phisp/diyBMSv4/README

Slave Boards: 4.4mA
Master Board: 90 mA with pcf8574

2.5V Referenzspannung statt 2.048V!

Soldering:
Use flux!
Burn In Tests

Improvements:
1024 Slave Boards
Lower Current Consumption: Slave -> <1mA Master -> Stb: <1mA

Issues:

more than 500mV difference causes packet loss
Slave Stops Operating
