phisp/diyBMSv4/CellModules_LCSC_BillOfMaterials.xlsx

ID | LCSC Part Number | Manufacture Part Number | Manufacturer | Package | Description | RoHS | Order Qty. | Min\Mult Order Qty. | Unit Price | Order Price | Product Link
D3 | C84256 | FC-2012HRK-620D | Foshan NationStar Optoelectronics | 0805 | Light Emitting Diodes (LED) Red 615~630nm 67~195mcd@20mA Top View 0805 RoHS | yes | 500 | 50\50 | 0.01290 | 6.45 | https://lcsc.com/product-detail/Light-Emitting-Diodes-LED_Red-LED-SMDLED-80-180mcd_C84256.html
D4 | C84260 | FC-2012UGK-520D5 | Foshan NationStar Optoelectronics | 0805 | Light Emitting Diodes (LED) Green 525~537.5nm 180~400mcd@5mA Top View 0805 RoHS | yes | 200 | 20\20 | 0.01520 | 3.04 | https://lcsc.com/product-detail/Light-Emitting-Diodes-LED_Emerald-SMDLED-Iv-220-270mcd-atIF-5mA_C84260.html
Q1 | C143946 | IRLML6244TRPBF | Infineon Technologies | SOT-23(SOT-23-3) | MOSFET N Trench 20V 6.3A 1.1V @ 10uA 21 mΩ @ 6.3A，4.5V SOT-23(SOT-23-3) RoHS | yes | 200 | 5\5 | 0.06570 | 13.14 | https://lcsc.com/product-detail/MOSFET_Infineon-Technologies_IRLML6244TRPBF_Infineon-Technologies-IRLML6244TRPBF_C143946.html
~~R1 Doppelt?~~ | ~~C17414~~ | ~~0805W8F1002T5E~~ | ~~Uniroyal Elec~~ | ~~0805~~ | ~~Chip Resistor - Surface Mount 10KOhms ±1% 1/8W 0805 RoHS~~ | ~~yes~~ | ~~1000~~ | ~~100\100~~ | ~~0.00100~~ | ~~1.00~~ | ~~https://lcsc.com/product-detail/Chip-Resistor-Surface-Mount_Uniroyal-Elec-0805W8F1002T5E_C17414.html~~
R1 | C84376 | RC0805FR-0710KL | YAGEO | 0805 | Chip Resistor - Surface Mount 10KOhms ±1% 1/8W 0805 RoHS | yes | 100 | 100\100 | 0.00170 | 0.17 | https://lcsc.com/product-detail/Chip-Resistor-Surface-Mount_10KR-1002-1_C84376.html
~~R2 Doppelt?~~ | ~~C95781~~ | ~~RC0805FR-071KL~~ | ~~YAGEO~~ | ~~0805~~ | ~~Chip Resistor - Surface Mount 1KOhms ±1% 1/8W 0805 RoHS~~ | ~~yes~~ | ~~1000~~ | ~~100\100~~ | ~~0.00110~~ | ~~1.10~~ | ~~https://lcsc.com/product-detail/Chip-Resistor-Surface-Mount_1KR-1000-1_C95781.html~~
R2 | C115316 | RS-05K1001FT | Guangdong Fenghua Advanced Tech | 0805 | Chip Resistor - Surface Mount 1KOhms ±1% 1/8W 0805 RoHS | yes | 1000 | 100\100 | 0.00100 | 1.00 | https://lcsc.com/product-detail/Chip-Resistor-Surface-Mount_1KR-1001-1_C115316.html
R15, R20, R21 | C126351 | RC0805FR-0747KL | YAGEO | 0805 | Chip Resistor - Surface Mount 47KOhms ±1% 1/8W 0805 RoHS | yes | 1000 | 50\50 | 0.00470 | 3.20 | https://lcsc.com/product-detail/Chip-Resistor-Surface-Mount_47KR-4702-1_C126351.html
 | C95969 | SDNT2012X473F4150FTF | Sunlord | 0805 | NTC Thermistors 1/5W 47KOhms ±1% 4150K 0805 RoHS | yes | 20 | 10\10 | 0.03940 |  | https://lcsc.com/product-detail/NTC-Thermistors_47K-1-B-4150_C95969.html
 |  |  | Epcos | 0805 | NTC von Epcos 10k +-2% SMD-Geh. 0805 bleifrei |  | 10 | 10\10 | 0.25000 | 2.50 | https://www.ebay.de/itm/10-St-NTC-von-Epcos-10k-2-SMD-Geh-0805-bleifrei
U1, ESP_U2 Punkt Links | C232857 | HMHA2801 | ON Semicon | SOP-4_P1.27 | DIP Optocouplers SOP-4_P1.27 RoHS | yes | 150 | 1\1 | 0.17733 | 26.60 | https://lcsc.com/product-detail/DIP-Optocouplers_ON-Semicon_HMHA2801_ON-Semicon-ON-HMHA2801_C232857.html
C1 | C49678 | CC0805KRX7R9BB104 | YAGEO | 0805 | Multilayer Ceramic Capacitors MLCC - SMD/SMT 100nF 50V 0805 RoHS | yes | 500 | 50\50 | 0.00490 | 2.45 | https://lcsc.com/product-detail/Multilayer-Ceramic-Capacitors-MLCC-SMD-SMT_100nF-104-10-50V_C49678.html
C2 | C113841 | CC0805KKX5R7BB225 | YAGEO | 0805 | Multilayer Ceramic Capacitors MLCC - SMD/SMT 2.2uF 16V 0805 RoHS | yes | 200 | 20\20 | 0.02090 | 3.45 | https://lcsc.com/product-detail/Multilayer-Ceramic-Capacitors-MLCC-SMD-SMT_2-2uF-225-10-16V_C113841.html
C3 | C272880 | CC0805KRX5R6BB106 | YAGEO | 0805 | Multilayer Ceramic Capacitors MLCC - SMD/SMT 10uF 10V 0805 RoHS | yes | 200 | 20\20 | 0.01760 | 3.52 | https://lcsc.com/product-detail/Others_YAGEO-CC0805KRX5R6BB106_C272880.html
D2 | C189307 | BL-HB335B-TRB-6 | Bright LED Elec | 0805 | Light Emitting Diodes (LED) Blue 465~470nm 25mcd@5mA 0805 RoHS | yes | 200 | 20\20 | 0.01460 | 2.92 | https://lcsc.com/product-detail/Light-Emitting-Diodes-LED_SMDLED-blue_C189307.html
- | C65114 | - | Boom Precision Elec | P=2.54mm | Pin Header / Female Header 0.100"（2.54mm） P=2.54mm RoHS | yes | 200 | 20\20 | 0.01440 | 2.88 | https://lcsc.com/product-detail/Pin-Header-Female-Header_Boom-Precision-Elec-2-54mm-2-3P-Header_C65114.html
~~doppelt~~ | ~~C124379~~ | ~~-~~ | ~~Shenzhen Cankemeng~~ | ~~Plugin~~ | ~~Pin Header / Female Header 0.100"（2.54mm） Plugin RoHS~~ | ~~yes~~ | ~~200~~ | ~~20\20~~ | ~~0.02040~~ | ~~4.08~~ | ~~https://lcsc.com/product-detail/Pin-Header-Female-Header_Shenzhen-Cankemeng-Headers-Pins-1-5P-2-54mm-Straight-line_C124379.html~~
- | C173752 | S2B-PH-K-S(LF)(SN) | JST Sales America | P=2mm | Wire To Board / Wire To Wire Connector P=2mm RoHS | yes | 400 | 10\10 | 0.02560 | 10.24 | https://lcsc.com/product-detail/Wire-To-Board-Wire-To-Wire-Connector_JST-Sales-America_S2B-PH-K-S-LF-SN_JST-Sales-America-S2B-PH-K-S-LF-SN_C173752.html
R3 | C137521 | RC0805FR-07475KL | YAGEO | 0805 | Chip Resistor - Surface Mount 475KOhms ±1% 1/8W 0805 RoHS | yes | 1000 | 100\100 | 0.00120 | 1.20 | https://lcsc.com/product-detail/_RC0805FR-07475KL_C137521.html
R4 | C17680 | 0805W8F4023T5E | Uniroyal Elec | 0805 | Chip Resistor - Surface Mount 402KOhms ±1% 1/8W 0805 RoHS | yes | 1000 | 100\100 | 0.00110 | 1.10 | https://lcsc.com/product-detail/Chip-Resistor-Surface-Mount_Uniroyal-Elec-0805W8F4023T5E_C17680.html
R5, R14 | C114563 | RC0805FR-07510RL | YAGEO | 0805 | Chip Resistor - Surface Mount 510Ohms ±1% 1/8W 0805 RoHS | yes | 1000 | 100\100 | 0.00120 | 1.20 | https://lcsc.com/product-detail/Chip-Resistor-Surface-Mount_510R-510R-1_C114563.html
R6, R7, R8, R9, R10, R11, R12, R13 | C147074 | CR2512F2R20E04S | Ever Ohms Tech | 2512 | Chip Resistor - Surface Mount 2.2Ohms ±1% 1W 2512 RoHS | yes | 1000 | 10\10 | 0.02190 | 21.90 | https://lcsc.com/product-detail/Chip-Resistor-Surface-Mount_Ever-Ohms-Tech-CR2512F2R2E04_C147074.html
R16, ESP_R2, ESP_R4, ESP_R5 | C60816 | RC0805FR-074K7L | YAGEO | 0805 | Chip Resistor - Surface Mount 4.7KOhms ±1% 1/8W 0805 RoHS | yes | 1000 | 50\50 | 0.00310 | 3.10 | https://lcsc.com/product-detail/Chip-Resistor-Surface-Mount_4-7K-4701-1_C60816.html
R17, R18, R23 | C114561 | RC0805FR-072K2L | YAGEO | 0805 | Chip Resistor - Surface Mount 2.2KOhms ±1% 1/8W 0805 RoHS | yes | 100 | 100\100 | 0.00150 | 0.15 | https://lcsc.com/product-detail/Chip-Resistor-Surface-Mount_2-2KR-2201-1_C114561.html
D1 Mouser: | 926-LM4040BIM325NOPB | LM4040BIM3-2.5/NOPB |  | SOT-23-3 | Spannungsreferenzen PREC MICROPWR SHUNT VLTG REF 2.5V | yes | 100 | 1\1 | 0.73200 | 73.20 | https://www.mouser.de/ProductDetail/Texas-Instruments/LM4040BIM3-25-NOPB
IC1 Mouser: | 556-ATTINY841-SSU | ATTINY841-SSU | Microchip Technology / Atmel | SOIC-14 | 8-Bit Mikrocontroller - MCU AVR 8K FLASH EE | yes | 100 | 1\1 | 0.77900 | 77.90 | https://www.mouser.de/ProductDetail/556-ATTINY841-SSU
Platine |  |  |  |  |  |  | 100 |  |  | 20.5
 |  |  |  |  |  |  | 100 | Gesamt: | 2.81540 | 281.54 |  | 100 | Gesamt: | 2.67490 | 267.49
ESP
ESP_R1 ebay | C114564 | RC0805FR-07470RL |  | 0805 | Chip Resistor - Surface Mount 470Ohms ±1% 1/8W 0805 RoHS |  | 100 | 100\100 | 0.01150 | 1.15
ESP_R3 ebay | C101564 | CR0805F82200G |  | 0805 | Chip Resistor - Surface Mount 220Ohms ±1% 1/8W 0805 RoHS |  | 100 | 100\100 | 0.01150 | 1.15
Wemos D1 Mini WLAN Mikrokontroller Wifi Nodemcu ebay |  |  |  |  | ESP8266 |  | 10 | 1\1 | 4.79000 | 47.90
 | C86832 | PCF8574AT/3,518 | NXP Semicon | SOIC-16_300mil | I/O Expansion 8 I2C SOIC-16_300mil RoHS | Yes | 100 | 1\1 | 0.74390 | 74.39 | https://lcsc.com/product-detail/I-O-Expansion_NXP_PCF8574AT-3-518_PCF8574AT-3-518_C86832.html
Platine |  |  |  |  |  |  | 10 |  |  | 10.30
 |  |  |  |  |  |  | 10 | Gesamt: | 13.48900 | 134.89
