phisp/diyBMSv4/CellModuleCircuit/v4.csv

Source: | E:\source\diyBMSv4\Circuit\v4.sch
Date: | 01/07/2019 21:15:38
Tool: | Eeschema (5.1.0)-1
Generator: | C:\Program Files\KiCad\bin\scripting\plugins/bom_csv_grouped_by_value.py
Component Count: | 38
Individual Components:
Item | Qty | Reference(s) | Value | LibPart | Footprint | Datasheet
 |  | C1 | 100nF | Device:C | Capacitors_SMD:C_0805_HandSoldering | https://lcsc.com/product-detail/Multilayer-Ceramic-Capacitors-MLCC-SMD-SMT_100nF-104-10-50V_C49678.html
 |  | C2 | 2.2uF | Device:C | Capacitors_SMD:C_0805_HandSoldering | https://lcsc.com/product-detail/Multilayer-Ceramic-Capacitors-MLCC-SMD-SMT_2-2uF-225-10-16V_C113841.html
 |  | C3 | 10uF 10V | Device:C | Capacitors_SMD:C_0805_HandSoldering | https://datasheet.lcsc.com/szlcsc/YAGEO-CC0805KRX5R6BB106_C272880.pdf
 |  | D1 | LM4040BIM3-2.0/NOPB, 2.048V, SOT-23-3 | Reference_Voltage:LM4040DBZ-2.0 | TO_SOT_Packages_SMD:SOT-23 | https://uk.farnell.com/texas-instruments/lm4040bim3-2-0-nopb/voltage-ref-shunt-2-048v-sot-23/dp/2492201
 |  | D2 | Blue | Device:LED | LEDs:LED_0805 | https://lcsc.com/product-detail/Light-Emitting-Diodes-LED_SMDLED-blue_C189307.html
 |  | D3 | RED LED | Device:LED | LEDs:LED_0805_HandSoldering | https://lcsc.com/product-detail/Light-Emitting-Diodes-LED_BL-HUF35A-AV-TRB-Iv-80mcd-Typ-atIF-20mA_C94741.html
 |  | D4 | Green | Device:LED | LEDs:LED_0805_HandSoldering | https://lcsc.com/product-detail/Light-Emitting-Diodes-LED_Emerald-SMDLED-Iv-220-270mcd-atIF-5mA_C84260.html
 |  | J2 | AVR-ISP-6 | Connector:AVR-ISP-6 | Pin_Headers:Pin_Header_Straight_2x03_Pitch2.54mm | https://lcsc.com/product-detail/Pin-Header-Female-Header_Boom-Precision-Elec-2-54mm-2-3P-Header_C65114.html
 |  | POWER1 | Battery | Connector:Conn_01x02_Male | Connectors_JST:JST_PH_S2B-PH-K_02x2.00mm_Angled | https://datasheet.lcsc.com/szlcsc/JST-Sales-America-S2B-PH-K-S-LF-SN_C173752.pdf
 |  | Q1 | IRLML6244TRPBF | Device:Q_NMOS_GSD | TO_SOT_Packages_SMD:SOT-23 | https://datasheet.lcsc.com/szlcsc/Infineon-Technologies-IRLML6244TRPBF_C143946.pdf
 |  | R1 | 10K | Device:R | Resistors_SMD:R_0805_HandSoldering | RC0805FR-0710KL
 |  | R2 | 1K | Device:R | Resistors_SMD:R_0805_HandSoldering | RC0805FR-071KL
 |  | R3 | 475K E96 series (tolerance 1%) | Device:R | Resistors_SMD:R_0805_HandSoldering | RC0805FR-07475KL
 |  | R4 | 402K E96 series (tolerance 1%) | Device:R | Resistors_SMD:R_0805_HandSoldering | 0805W8F4023T5E
 |  | R5 | 510R | Device:R | Resistors_SMD:R_0805_HandSoldering | RC0805FR-07510RL
 |  | R6 | 2R2 1W | Device:R | Resistors_SMD:R_2512 | https://datasheet.lcsc.com/szlcsc/Ever-Ohms-Tech-CR2512F2R2E04_C147074.pdf
 |  | R7 | 2R2 1W | Device:R | Resistors_SMD:R_2512 | https://datasheet.lcsc.com/szlcsc/Ever-Ohms-Tech-CR2512F2R2E04_C147074.pdf
 |  | R8 | 2R2 1W | Device:R | Resistors_SMD:R_2512 | https://datasheet.lcsc.com/szlcsc/Ever-Ohms-Tech-CR2512F2R2E04_C147074.pdf
 |  | R9 | 2R2 1W | Device:R | Resistors_SMD:R_2512 | https://datasheet.lcsc.com/szlcsc/Ever-Ohms-Tech-CR2512F2R2E04_C147074.pdf
 |  | R10 | 2R2 1W | Device:R | Resistors_SMD:R_2512 | https://datasheet.lcsc.com/szlcsc/Ever-Ohms-Tech-CR2512F2R2E04_C147074.pdf
 |  | R11 | 2R2 1W | Device:R | Resistors_SMD:R_2512 | https://datasheet.lcsc.com/szlcsc/Ever-Ohms-Tech-CR2512F2R2E04_C147074.pdf
 |  | R12 | 2R2 1W | Device:R | Resistors_SMD:R_2512 | https://datasheet.lcsc.com/szlcsc/Ever-Ohms-Tech-CR2512F2R2E04_C147074.pdf
 |  | R13 | 2R2 1W | Device:R | Resistors_SMD:R_2512 | https://datasheet.lcsc.com/szlcsc/Ever-Ohms-Tech-CR2512F2R2E04_C147074.pdf
 |  | R14 | 510R | Device:R | Resistors_SMD:R_0805_HandSoldering | RC0805FR-07510RL
 |  | R15 | 47K | Device:R | Resistors_SMD:R_0805_HandSoldering | https://datasheet.lcsc.com/szlcsc/YAGEO-RC0805FR-0747KL_C126351.pdf
 |  | R16 | 4K7 | Device:R | Resistors_SMD:R_0805_HandSoldering | RC0805FR-074K7L
 |  | R17 | 2K2 | Device:R | Resistors_SMD:R_0805_HandSoldering | RC0805FR-072K2L
 |  | R18 | 2K2 | Device:R | Resistors_SMD:R_0805_HandSoldering | RC0805FR-072K2L
 |  | R19 | SDNT2012X473F4150FTF | Device:Thermistor | Resistors_SMD:R_0805_HandSoldering | https://datasheet.lcsc.com/szlcsc/Sunlord-SDNT2012X473F4150FTF_C95969.pdf
 |  | R20 | 47K | Device:R | Resistors_SMD:R_0805_HandSoldering | https://datasheet.lcsc.com/szlcsc/YAGEO-RC0805FR-0747KL_C126351.pdf
 |  | R21 | 47K | Device:R | Resistors_SMD:R_0805_HandSoldering | https://datasheet.lcsc.com/szlcsc/YAGEO-RC0805FR-0747KL_C126351.pdf
 |  | R22 | 10R | Device:R | Resistors_THT:R_Axial_Power_L25.0mm_W9.0mm_P27.94mm | https://lcsc.com/product-detail/Others_Chian-Chia-Elec-CR-M5W-10RJ_C334310.html
 |  | R23 | 2K2 | Device:R | Resistors_SMD:R_0805 | RC0805FR-072K2L
 |  | RX1 | RX Connector | Connector:Conn_01x02_Male | Connectors_JST:JST_PH_S2B-PH-K_02x2.00mm_Angled | https://datasheet.lcsc.com/szlcsc/JST-Sales-America-S2B-PH-K-S-LF-SN_C173752.pdf
 |  | SENSOR1 | Remote temp input 47K @ 25oC | Connector:Conn_01x05_Male | Pin_Headers:Pin_Header_Straight_1x05_Pitch2.54mm | https://lcsc.com/product-detail/Pin-Header-Female-Header_Shenzhen-Cankemeng-Headers-Pins-1-5P-2-54mm-Straight-line_C124379.html
 |  | TX1 | TX Connector | Connector:Conn_01x02_Male | Connectors_JST:JST_PH_S2B-PH-K_02x2.00mm_Angled | https://datasheet.lcsc.com/szlcsc/JST-Sales-America-S2B-PH-K-S-LF-SN_C173752.pdf
 |  | U1 | HMHA2801 | Isolator:PC817 | Housings_SSOP:SOP-4_4.4x2.8mm_Pitch1.27mm | https://datasheet.lcsc.com/szlcsc/ON-Semicon-ON-HMHA2801_C232857.pdf
 |  | U4 | ATtiny841-SSU | v4-rescue:ATtiny841-SSU-MCU_Microchip_ATtiny-v4-rescue | Housings_SOIC:SOIC-14_3.9x8.7mm_Pitch1.27mm | http://ww1.microchip.com/downloads/en/DeviceDoc/Atmel-8495-8-bit-AVR-Microcontrollers-ATtiny441-ATtiny841_Datasheet.pdf
Collated Components:
Item | Qty | Reference(s) | Value | LibPart | Footprint | Datasheet
1 | 1 | C1 | 100nF | Device:C | Capacitors_SMD:C_0805_HandSoldering | https://lcsc.com/product-detail/Multilayer-Ceramic-Capacitors-MLCC-SMD-SMT_100nF-104-10-50V_C49678.html
2 | 1 | C2 | 2.2uF | Device:C | Capacitors_SMD:C_0805_HandSoldering | https://lcsc.com/product-detail/Multilayer-Ceramic-Capacitors-MLCC-SMD-SMT_2-2uF-225-10-16V_C113841.html
3 | 1 | C3 | 10uF 10V | Device:C | Capacitors_SMD:C_0805_HandSoldering | https://datasheet.lcsc.com/szlcsc/YAGEO-CC0805KRX5R6BB106_C272880.pdf
4 | 1 | D1 | LM4040BIM3-2.0/NOPB, 2.048V, SOT-23-3 | Reference_Voltage:LM4040DBZ-2.0 | TO_SOT_Packages_SMD:SOT-23 | https://uk.farnell.com/texas-instruments/lm4040bim3-2-0-nopb/voltage-ref-shunt-2-048v-sot-23/dp/2492201
5 | 1 | D2 | Blue | Device:LED | LEDs:LED_0805 | https://lcsc.com/product-detail/Light-Emitting-Diodes-LED_SMDLED-blue_C189307.html
6 | 1 | D3 | RED LED | Device:LED | LEDs:LED_0805_HandSoldering | https://lcsc.com/product-detail/Light-Emitting-Diodes-LED_BL-HUF35A-AV-TRB-Iv-80mcd-Typ-atIF-20mA_C94741.html
7 | 1 | D4 | Green | Device:LED | LEDs:LED_0805_HandSoldering | https://lcsc.com/product-detail/Light-Emitting-Diodes-LED_Emerald-SMDLED-Iv-220-270mcd-atIF-5mA_C84260.html
8 | 1 | J2 | AVR-ISP-6 | Connector:AVR-ISP-6 | Pin_Headers:Pin_Header_Straight_2x03_Pitch2.54mm | https://lcsc.com/product-detail/Pin-Header-Female-Header_Boom-Precision-Elec-2-54mm-2-3P-Header_C65114.html
9 | 1 | POWER1 | Battery | Connector:Conn_01x02_Male | Connectors_JST:JST_PH_S2B-PH-K_02x2.00mm_Angled | https://datasheet.lcsc.com/szlcsc/JST-Sales-America-S2B-PH-K-S-LF-SN_C173752.pdf
10 | 1 | Q1 | IRLML6244TRPBF | Device:Q_NMOS_GSD | TO_SOT_Packages_SMD:SOT-23 | https://datasheet.lcsc.com/szlcsc/Infineon-Technologies-IRLML6244TRPBF_C143946.pdf
11 | 1 | R1 | 10K | Device:R | Resistors_SMD:R_0805_HandSoldering | RC0805FR-0710KL
12 | 1 | R2 | 1K | Device:R | Resistors_SMD:R_0805_HandSoldering | RC0805FR-071KL
13 | 1 | R3 | 475K E96 series (tolerance 1%) | Device:R | Resistors_SMD:R_0805_HandSoldering | RC0805FR-07475KL
14 | 1 | R4 | 402K E96 series (tolerance 1%) | Device:R | Resistors_SMD:R_0805_HandSoldering | 0805W8F4023T5E
15 | 2 | R5, R14 | 510R | Device:R | Resistors_SMD:R_0805_HandSoldering | RC0805FR-07510RL
16 | 8 | R6, R7, R8, R9, R10, R11, R12, R13 | 2R2 1W | Device:R | Resistors_SMD:R_2512 | https://datasheet.lcsc.com/szlcsc/Ever-Ohms-Tech-CR2512F2R2E04_C147074.pdf
17 | 3 | R15, R20, R21 | 47K | Device:R | Resistors_SMD:R_0805_HandSoldering | https://datasheet.lcsc.com/szlcsc/YAGEO-RC0805FR-0747KL_C126351.pdf
18 | 1 | R16 | 4K7 | Device:R | Resistors_SMD:R_0805_HandSoldering | RC0805FR-074K7L
19 | 2 | R17, R18 | 2K2 | Device:R | Resistors_SMD:R_0805_HandSoldering | RC0805FR-072K2L
20 | 1 | R19 | SDNT2012X473F4150FTF | Device:Thermistor | Resistors_SMD:R_0805_HandSoldering | https://datasheet.lcsc.com/szlcsc/Sunlord-SDNT2012X473F4150FTF_C95969.pdf
21 | 1 | R22 | 10R | Device:R | Resistors_THT:R_Axial_Power_L25.0mm_W9.0mm_P27.94mm | https://lcsc.com/product-detail/Others_Chian-Chia-Elec-CR-M5W-10RJ_C334310.html
22 | 1 | R23 | 2K2 | Device:R | Resistors_SMD:R_0805 | RC0805FR-072K2L
23 | 1 | RX1 | RX Connector | Connector:Conn_01x02_Male | Connectors_JST:JST_PH_S2B-PH-K_02x2.00mm_Angled | https://datasheet.lcsc.com/szlcsc/JST-Sales-America-S2B-PH-K-S-LF-SN_C173752.pdf
24 | 1 | SENSOR1 | Remote temp input 47K @ 25oC | Connector:Conn_01x05_Male | Pin_Headers:Pin_Header_Straight_1x05_Pitch2.54mm | https://lcsc.com/product-detail/Pin-Header-Female-Header_Shenzhen-Cankemeng-Headers-Pins-1-5P-2-54mm-Straight-line_C124379.html
25 | 1 | TX1 | TX Connector | Connector:Conn_01x02_Male | Connectors_JST:JST_PH_S2B-PH-K_02x2.00mm_Angled | https://datasheet.lcsc.com/szlcsc/JST-Sales-America-S2B-PH-K-S-LF-SN_C173752.pdf
26 | 1 | U1 | HMHA2801 | Isolator:PC817 | Housings_SSOP:SOP-4_4.4x2.8mm_Pitch1.27mm | https://datasheet.lcsc.com/szlcsc/ON-Semicon-ON-HMHA2801_C232857.pdf
27 | 1 | U4 | ATtiny841-SSU | v4-rescue:ATtiny841-SSU-MCU_Microchip_ATtiny-v4-rescue | Housings_SOIC:SOIC-14_3.9x8.7mm_Pitch1.27mm | http://ww1.microchip.com/downloads/en/DeviceDoc/Atmel-8495-8-bit-AVR-Microcontrollers-ATtiny441-ATtiny841_Datasheet.pdf
