phisp/diyBMSv4/ESPControllerCircuit/ESPControllerSchematic.pdf

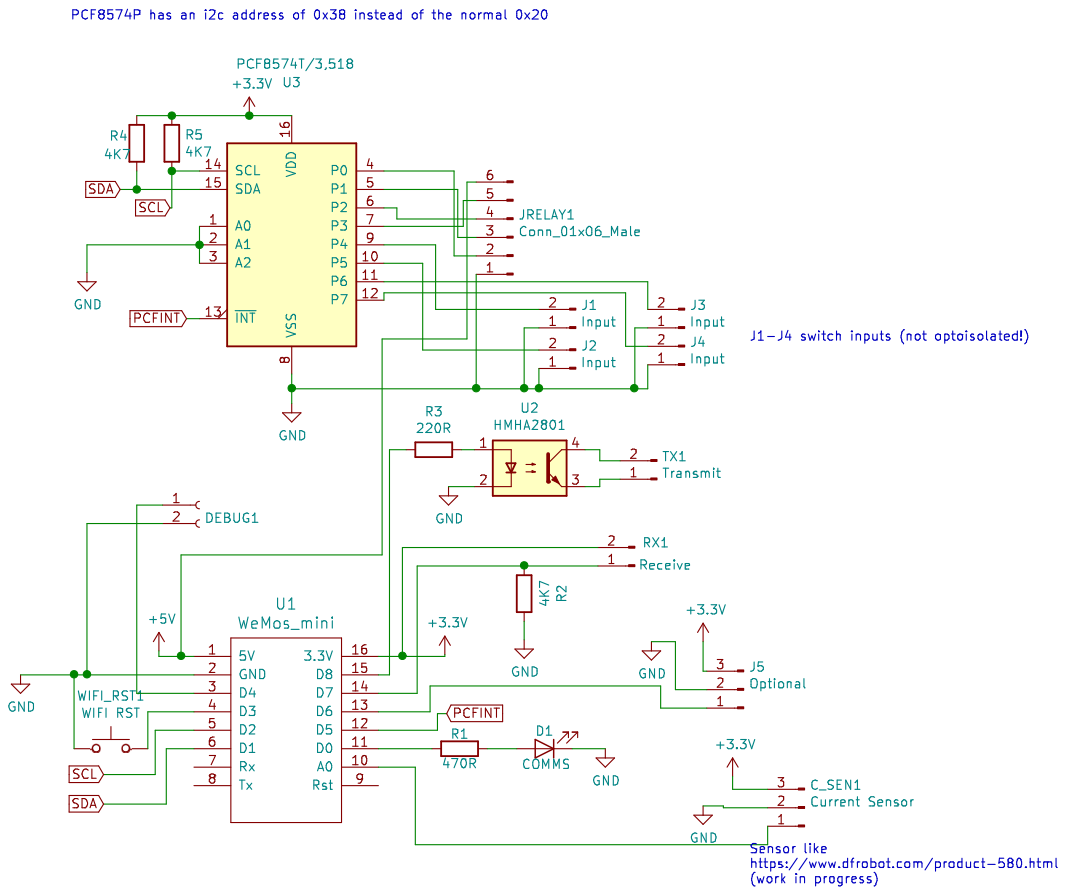
[picture p5: page 1]
