phisp/diyBMSv4/ESPController/include/PacketReceiveProcessor.h

#ifndef PacketReceiveProcessor_H_
#define PacketReceiveProcessor_H_

#include <Arduino.h>
#include "defines.h"

#include "../lib/crc16/crc16.h"
#include <cppQueue.h>

class PacketReceiveProcessor {
   public:
     PacketReceiveProcessor() {}
     ~PacketReceiveProcessor() {}
     bool ProcessReply(const uint8_t* receivebuffer, uint16_t sequenceToExpect);
     bool HasCommsTimedOut();
     //uint16_t totalMissedPacketCount=0;
     uint16_t totalCRCErrors=0;
     uint16_t totalNotProcessedErrors=0;

     uint32_t packetsReceived = 0;

     //Timer for "read voltage" packets (default to 1 minute at startup)
     uint32_t packetTimerMillisecond = 60*1000;
     uint32_t packetLastReceivedMillisecond = 0;
     uint16_t packetLastSentSequence = 0;
     uint32_t packetLastSentMillisecond = 0;

  private:
    packet _packetbuffer;
    uint8_t ReplyFromBank() {return (_packetbuffer.address & B00110000) >> 4;}
    //See issue 11 - if we receive zero for the address then we have 16 modules or no modules and a loop
    uint8_t ReplyLastAddress();
    uint8_t ReplyLastAddressRaw();
    uint8_t ReplyForCommand() { return (_packetbuffer.command & 0x0F); }
    bool ReplyWasProcessedByAModule() {return (_packetbuffer.command & B10000000)>0;}

    void ProcessReplySettings();
    void ProcessReplyVoltage();
    void ProcessReplyTemperature();
    void ProcessReplyAddressByte();
    void ProcessReplyBadPacketCount();
    void ProcessReplyBalancePower();

};



#endif
