phisp/diyBMSv4/(notices)

Notices in the files:
CellModuleCircuit/v4.kicad_pcb:
©2019 Stuart Pittaway
